markadev/AppleII-Keyboard/AppleII-Keyboard/AppleII-Keyboard.pdf

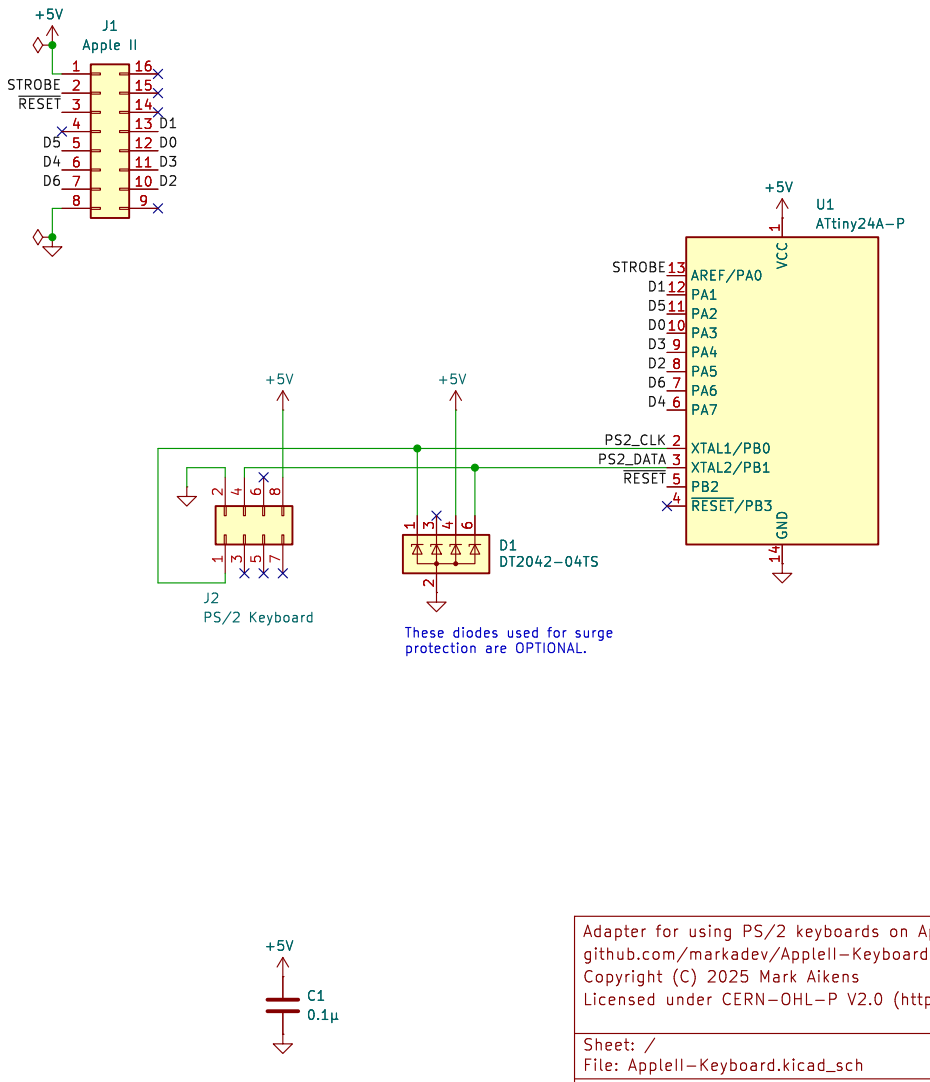
[picture p3: page 1]

~{RESET} PS2_CLKD2 These diodes used for surge
