markadev/AppleII-Keyboard/AppleII-Keyboard-Connector/AppleII-Keyboard-Connector.kicad_sch

## KiCad design AppleII-Keyboard-Connector/AppleII-Keyboard-Connector.kicad_sch (2025-10-14)

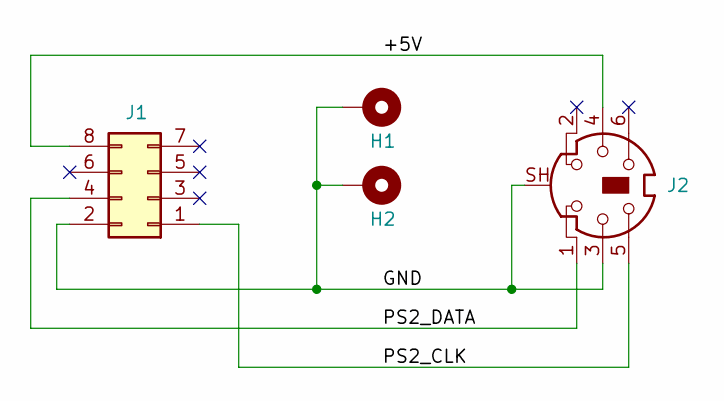
[picture p4: schematic AppleII-Keyboard-Connector.kicad_sch]

Parts:
H1, H2: MountingHole_Pad; MountingHole_3.2mm_M3_DIN965_Pad
J1: Conn_02x04_Odd_Even; PinHeader_2x04_P2.54mm_Vertical
J2: Shielded-Mini-DIN-6; Mini_DIN_round_6_canned

Connections:
+5V: J1.8, J2.4
GND: H1.1, H2.1, J1.2, J2.3, J2.SH
PS2_CLK: J1.1, J2.5
PS2_DATA: J1.4, J2.1
