markadev/AppleII-Keyboard/AppleII-Keyboard/AppleII-Keyboard.kicad_sch

## KiCad design AppleII-Keyboard/AppleII-Keyboard.kicad_sch (2025-10-14)

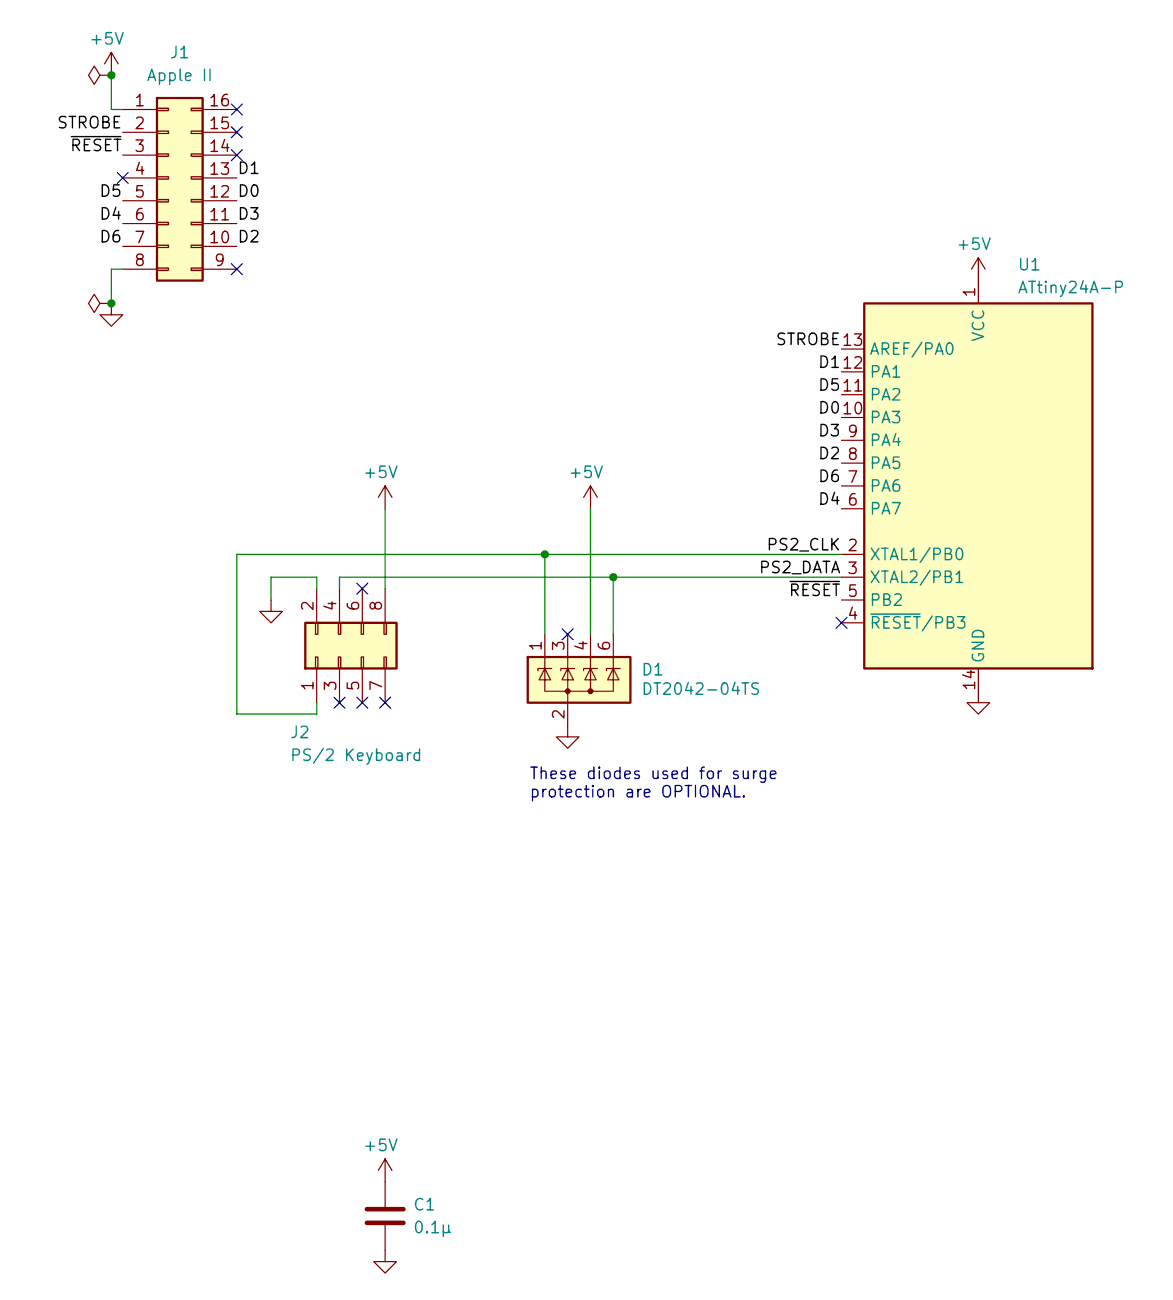
[picture p5: schematic AppleII-Keyboard.kicad_sch]

Parts:
C1: 0.1µ; C_Axial_L3.8mm_D2.6mm_P7.50mm_Horizontal
D1: DT2042-04TS; TSOT-23-6_HandSoldering; MfrPartNo DT2042-04TS-7; MouserPartNo 621-DT2042-04TS-7
J1: Apple II; DIP-16_W7.62mm_UndersidePins
J2: PS/2 Keyboard; PinHeader_2x04_P2.54mm_Vertical
U1: ATtiny24A-P; DIP-14_W7.62mm_Socket; MfrPartNo ATTINY24A-PU; MouserPartNo 556-ATTINY24A-PU

Connections:
+5V: C1.1, D1.4 (K), J1.1, J2.8, U1.1 (VCC)
D0: J1.12, U1.10 (PA3)
D1: J1.13, U1.12 (PA1)
D2: J1.10, U1.8 (PA5)
D3: J1.11, U1.9 (PA4)
D4: J1.6, U1.6 (PA7)
D5: J1.5, U1.11 (PA2)
D6: J1.7, U1.7 (PA6)
GND: C1.2, D1.2 (A), J1.8, J2.2, U1.14 (GND)
PS2_CLK: D1.1 (K), J2.1, U1.2 (XTAL1/PB0)
PS2_DATA: D1.6 (K), J2.4, U1.3 (XTAL2/PB1)
STROBE: J1.2, U1.13 (AREF/PA0)
~RESET: J1.3, U1.5 (PB2)

Notes on the sheet:
These diodes used for surge protection are OPTIONAL.
