markadev/AppleII-Keyboard/src/AppleII_PS2_Keyboard/config.h

#pragma once

// PS/2 interface configuration
#define PS2_CLOCK_PIN 7
#define PS2_DATA_PIN 8
#define PS2_RX_BUFFER_SIZE 64

// AppleII interface configuration
#define AII_RESET_PIN 0
#define AII_STROBE_PIN 1
#define AII_DATA_PIN_0 20
#define AII_DATA_PIN_1 21
#define AII_DATA_PIN_2 18
#define AII_DATA_PIN_3 19
#define AII_DATA_PIN_4 4
#define AII_DATA_PIN_5 3
#define AII_DATA_PIN_6 5
