markadev/AppleII-Keyboard/src/PS2_Monitor/PS2_Monitor.ino

// This sketch will receive codes from the PS2 keyboard and print them to the serial console

#include "Arduino.h"
#include "PS2Keyboard.h"


PS2Keyboard kbd;


void ps2ClockIntHandler() {
  kbd.onClockFallingEdge();
}

void setup() {
  Serial.begin(115200);

  pinMode(PS2_CLOCK_PIN, INPUT_PULLUP); // clock
  pinMode(PS2_DATA_PIN, INPUT_PULLUP); // data
  attachInterrupt(digitalPinToInterrupt(PS2_CLOCK_PIN), ps2ClockIntHandler, FALLING);
}

void loop() {
  uint16_t d = kbd.getKeypress();
  if(d != 0) {
    Serial.print(d, HEX);
    Serial.write('\n');
  }
}
