markadev/AppleII-Keyboard/src/AppleII_PS2_Keyboard/AppleIIKeyboardTranslation.h

#pragma once

#include "PS2Keyboard.h"


// Class to translate PS2 scan codes into Apple II keyboard codes.
class AppleIIKeyboardTranslation {
public:
  AppleIIKeyboardTranslation(PS2Keyboard& kbd) : m_kbd(kbd) {}

  // Fetches the next encoded key code, or 0 if there isn't one.
  uint8_t getKeyCode();

private:
  PS2Keyboard& m_kbd;
  static const uint8_t translation[512][4] PROGMEM;
};

uint8_t AppleIIKeyboardTranslation::getKeyCode() {
  uint16_t ps2ScanCode = m_kbd.getKeypress() & 0x1ff;
  if(ps2ScanCode == 0) {
    return 0;
  }

  uint8_t modifiers = 0;
  if(m_kbd.isShiftPressed()) {
    modifiers |= 0x1;
  }
  if(m_kbd.isCtrlPressed()) {
    modifiers |= 0x2;
  }
  return pgm_read_byte(&(translation[ps2ScanCode][modifiers]));
}

// This table is generated from a script
// DO NOT EDIT
const uint8_t AppleIIKeyboardTranslation::translation[512][4] = {
  // scan code, no modifier, SHIFT modifier, CTRL modifier, both modifiers
  /* 0x000 */ {},
  /* 0x001 */ {},
  /* 0x002 */ {},
  /* 0x003 */ {},
  /* 0x004 */ {},
  /* 0x005 */ {},
  /* 0x006 */ {},
  /* 0x007 */ {},
  /* 0x008 */ {},
  /* 0x009 */ {},
  /* 0x00a */ {},
  /* 0x00b */ {},
  /* 0x00c */ {},
  /* 0x00d */ {},
  /* 0x00e */ {},
  /* 0x00f */ {},
  /* 0x010 */ {},
  /* 0x011 */ {},
  /* 0x012 */ {},
  /* 0x013 */ {},
  /* 0x014 */ {},
  /* 0x015      [Q] */ {0xd1, 0xd1, 0x91, 0x91},
  /* 0x016     [1!] */ {0xb1, 0xa1, 0xb1, 0xa1},
  /* 0x017 */ {},
  /* 0x018 */ {},
  /* 0x019 */ {},
  /* 0x01a      [Z] */ {0xda, 0xda, 0x9a, 0x9a},
  /* 0x01b      [S] */ {0xd3, 0xd3, 0x93, 0x93},
  /* 0x01c      [A] */ {0xc1, 0xc1, 0x81, 0x81},
  /* 0x01d      [W] */ {0xd7, 0xd7, 0x97, 0x97},
  /* 0x01e     [2@] */ {0xb2, 0xc0, 0xb2, 0xc0},
  /* 0x01f */ {},
  /* 0x020 */ {},
  /* 0x021      [C] */ {0xc3, 0xc3, 0x83, 0x83},
  /* 0x022      [X] */ {0xd8, 0xd8, 0x98, 0x98},
  /* 0x023      [D] */ {0xc4, 0xc4, 0x84, 0x84},
  /* 0x024      [E] */ {0xc5, 0xc5, 0x85, 0x85},
  /* 0x025     [4$] */ {0xb4, 0xa4, 0xb4, 0xa4},
  /* 0x026     [3#] */ {0xb3, 0xa3, 0xb3, 0xa3},
  /* 0x027 */ {},
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
  /* 0x029  [Space] */ {0xa0, 0xa0, 0xa0, 0xa0},
  /* 0x02a      [V] */ {0xd6, 0xd6, 0x96, 0x96},
  /* 0x02b      [F] */ {0xc6, 0xc6, 0x86, 0x86},
  /* 0x02c      [T] */ {0xd4, 0xd4, 0x94, 0x94},
  /* 0x02d      [R] */ {0xd2, 0xd2, 0x92, 0x92},
  /* 0x02e     [5%] */ {0xb5, 0xa5, 0xb5, 0xa5},
  /* 0x02f */ {},
  /* 0x030 */ {},
  /* 0x031      [N] */ {0xce, 0xce, 0x8e, 0x9e},
  /* 0x032      [B] */ {0xc2, 0xc2, 0x82, 0x82},
  /* 0x033      [H] */ {0xc8, 0xc8, 0x88, 0x88},
  /* 0x034      [G] */ {0xc7, 0xc7, 0x87, 0x87},
  /* 0x035      [Y] */ {0xd9, 0xd9, 0x99, 0x99},
  /* 0x036     [6^] */ {0xb6, 0xde, 0xb6, 0xde},
  /* 0x037 */ {},
  /* 0x038 */ {},
  /* 0x039 */ {},
  /* 0x03a      [M] */ {0xcd, 0xcd, 0x8e, 0x9d},
  /* 0x03b      [J] */ {0xca, 0xca, 0x8a, 0x8a},
  /* 0x03c      [U] */ {0xd5, 0xd5, 0x95, 0x95},
  /* 0x03d     [7&] */ {0xb7, 0xa6, 0xb7, 0xa6},
  /* 0x03e     [8*] */ {0xb8, 0xaa, 0xb8, 0xaa},
  /* 0x03f */ {},
  /* 0x040 */ {},
  /* 0x041     [,<] */ {0xac, 0xbc, 0xac, 0xbc},
  /* 0x042      [K] */ {0xcb, 0xcb, 0x8b, 0x8b},
  /* 0x043      [I] */ {0xc9, 0xc9, 0x89, 0x89},
  /* 0x044      [O] */ {0xcf, 0xcf, 0x8f, 0x8f},
  /* 0x045     [0)] */ {0xb0, 0xa9, 0xb0, 0xa9},
  /* 0x046     [9(] */ {0xb9, 0xa8, 0xb9, 0xa8},
  /* 0x047 */ {},
  /* 0x048 */ {},
  /* 0x049     [.>] */ {0xae, 0xbe, 0xae, 0xbe},
  /* 0x04a     [/?] */ {0xaf, 0xbf, 0xaf, 0xbf},
  /* 0x04b      [L] */ {0xcc, 0xcc, 0x8c, 0x8c},
  /* 0x04c     [;:] */ {0xbb, 0xba, 0xbb, 0xba},
  /* 0x04d      [P] */ {0xd0, 0xd0, 0x90, 0x80},
  /* 0x04e     [-_] */ {0xad, 0xad, 0xad, 0xad},
  /* 0x04f */ {},
  /* 0x050 */ {},
  /* 0x051 */ {},
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
  /* 0x05a  [Enter] */ {0x8d, 0x8d, 0x8d, 0x8d},
  /* 0x05b     []}] */ {0xdd, 0xdd, 0xdd, 0xdd},
  /* 0x05c */ {},
  /* 0x05d */ {},
  /* 0x05e */ {},
  /* 0x05f */ {},
  /* 0x060 */ {},
  /* 0x061 */ {},
  /* 0x062 */ {},
  /* 0x063 */ {},
  /* 0x064 */ {},
  /* 0x065 */ {},
  /* 0x066 */ {},
  /* 0x067 */ {},
  /* 0x068 */ {},
  /* 0x069 */ {},
  /* 0x06a */ {},
  /* 0x06b */ {},
  /* 0x06c */ {},
  /* 0x06d */ {},
  /* 0x06e */ {},
  /* 0x06f */ {},
  /* 0x070 */ {},
  /* 0x071 */ {},
  /* 0x072 */ {},
  /* 0x073 */ {},
  /* 0x074 */ {},
  /* 0x075 */ {},
  /* 0x076 [Escape] */ {0x9b, 0x9b, 0x9b, 0x9b},
  /* 0x077 */ {},
  /* 0x078 */ {},
  /* 0x079 */ {},
  /* 0x07a */ {},
  /* 0x07b */ {},
  /* 0x07c */ {},
  /* 0x07d */ {},
  /* 0x07e */ {},
  /* 0x07f */ {},
  /* 0x080 */ {},
  /* 0x081 */ {},
  /* 0x082 */ {},
  /* 0x083 */ {},
  /* 0x084 */ {},
  /* 0x085 */ {},
  /* 0x086 */ {},
  /* 0x087 */ {},
  /* 0x088 */ {},
  /* 0x089 */ {},
  /* 0x08a */ {},
  /* 0x08b */ {},
  /* 0x08c */ {},
  /* 0x08d */ {},
  /* 0x08e */ {},
  /* 0x08f */ {},
  /* 0x090 */ {},
  /* 0x091 */ {},
  /* 0x092 */ {},
  /* 0x093 */ {},
  /* 0x094 */ {},
  /* 0x095 */ {},
  /* 0x096 */ {},
  /* 0x097 */ {},
  /* 0x098 */ {},
  /* 0x099 */ {},
  /* 0x09a */ {},
  /* 0x09b */ {},
  /* 0x09c */ {},
  /* 0x09d */ {},
  /* 0x09e */ {},
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
  /* 0x16b [LeftArrow] */ {0x88, 0x88, 0x88, 0x88},
  /* 0x16c */ {},
  /* 0x16d */ {},
  /* 0x16e */ {},
  /* 0x16f */ {},
  /* 0x170 */ {},
  /* 0x171 */ {},
  /* 0x172 */ {},
  /* 0x173 */ {},
  /* 0x174 [RightArrow] */ {0x95, 0x95, 0x95, 0x95},
  /* 0x175 */ {},
  /* 0x176 */ {},
  /* 0x177 */ {},
  /* 0x178 */ {},
  /* 0x179 */ {},
  /* 0x17a */ {},
  /* 0x17b */ {},
  /* 0x17c [PrtScr] */ {0x00, 0x00, 0xff, 0xff},
  /* 0x17d */ {},
  /* 0x17e */ {},
  /* 0x17f */ {},
  /* 0x180 */ {},
  /* 0x181 */ {},
  /* 0x182 */ {},
  /* 0x183 */ {},
  /* 0x184 */ {},
  /* 0x185 */ {},
  /* 0x186 */ {},
  /* 0x187 */ {},
  /* 0x188 */ {},
  /* 0x189 */ {},
  /* 0x18a */ {},
  /* 0x18b */ {},
  /* 0x18c */ {},
  /* 0x18d */ {},
  /* 0x18e */ {},
  /* 0x18f */ {},
  /* 0x190 */ {},
  /* 0x191 */ {},
  /* 0x192 */ {},
  /* 0x193 */ {},
  /* 0x194 */ {},
  /* 0x195 */ {},
  /* 0x196 */ {},
  /* 0x197 */ {},
  /* 0x198 */ {},
  /* 0x199 */ {},
  /* 0x19a */ {},
  /* 0x19b */ {},
  /* 0x19c */ {},
  /* 0x19d */ {},
  /* 0x19e */ {},
  /* 0x19f */ {},
  /* 0x1a0 */ {},
  /* 0x1a1 */ {},
  /* 0x1a2 */ {},
  /* 0x1a3 */ {},
  /* 0x1a4 */ {},
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
};
