markadev/AppleII-Keyboard/(commit log)

2025-10-03 Fix idle level of the /RESET line.
    The /RESET line driver should be open-collector so don't drive it high - leave it floating
    (as a pin input) and only drive it low when asserting the signal.
2025-10-14 Commit custom PCB kicad projects
2025-10-14 Fix whitespace in the Arduino code
