markadev/AppleII-Keyboard/(notices)

Notices in the files:
AppleII-Keyboard/AppleII-Keyboard.kicad_sch:
Licensed under CERN-OHL-P V2.0 (https://ohwr.org/cern_ohl_p_v2.txt)
Copyright (C) 2025 Mark Aikens
